Stevie-Nicks-and-the-Xaybanha-Zhous/SelectiveBirdFeeder/design_review/Design Review.docx

Team 9

Stevie Taylor

Nick Short

Calvin Xaybanha

Zeming Zhou

Design Review

Reviewers: Team 12

Miles Breslin

Miguel Higgins Moy

Noah Page

John Sharpe

- To-Do
  - Schematic:
    - Need to add linear regulator and make sure voltage nets are applied properly.
    - Add ISP header.
  - Board:
    - Need thicker traces all around.
    - Primarily surface mount components.
    - Need to add stitching vias.
