Stevie-Nicks-and-the-Xaybanha-Zhous/SelectiveBirdFeeder/system_design_models/Modeling.pdf

## ECE 411 Engineering Practices “System Design II:

## Behavior Models”

## Portland State University

## Nick Short

## Stevie Taylor

## Calvin Xaybanha

## Zeming Zhou

# State Machine View

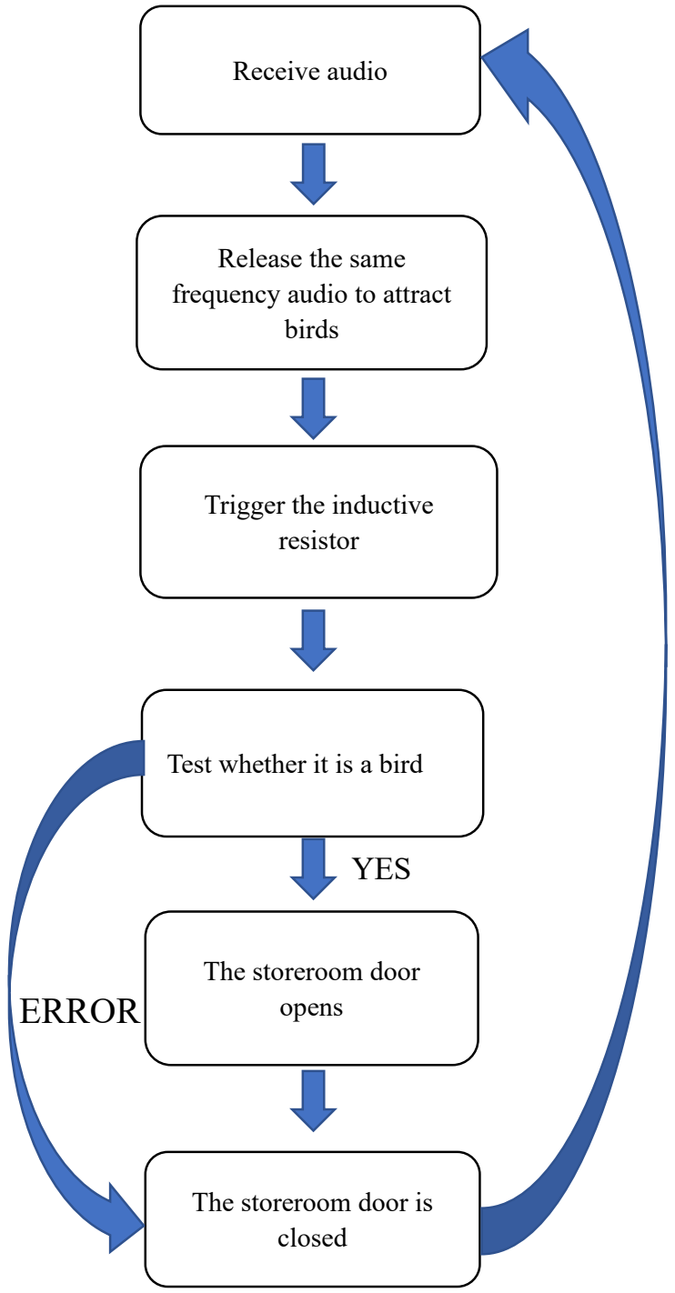
[picture p12: figure]
YES; ERROR; Receive audio; Release the same frequency audio to attract birds; Test whether it is a bird; The storeroom door opens; The storeroom door is closed; Trigger the inductive resistor

⚫ | Receives audio of the call of birds around the test device and tests the frequency range of
| the call.
⚫ | The audio, which is emitted at the same frequency as the receiving call, attracts birds to
| eat.
⚫ | Birds or other animals set out to sense the switch to test whether the animal belongs to the
| bird.
⚫ | If the test animal turns on the switch on the storage unit for birds.
⚫ | The bird leaves the sensor and receives a signal to turn off the switch on the storage device.

UML Activity View

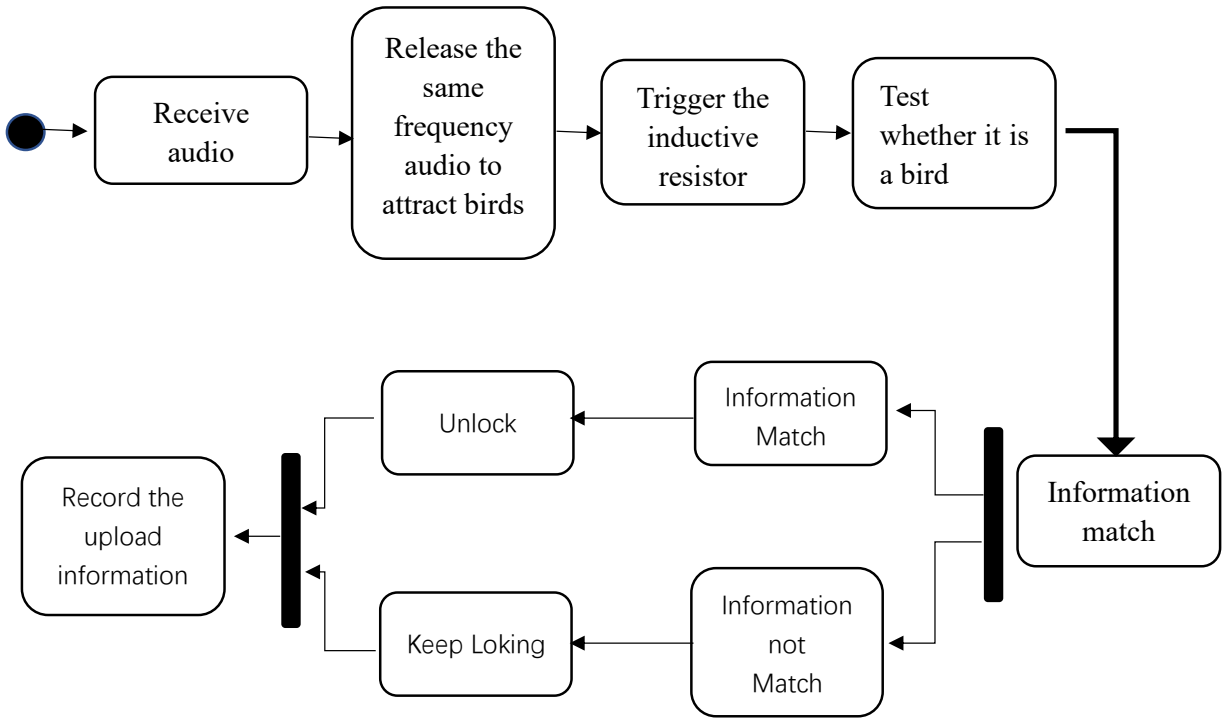
[picture p13: figure]
Receive audio; Release the same frequency audio to attract birds; Trigger the inductive resistor; Test whether it is a bird; Information match; Keep Loking; Information not Match; Unlock; Information Match; Record the upload information

The message that gets the bird's audio sends the same audio message to the bird to eat. When the sensor senses that an animal is in contact, it will determine whether the animal is a bird if the door circuit will be activated if it is not closed. Report bird information after the bird has finished eating.

Interaction View

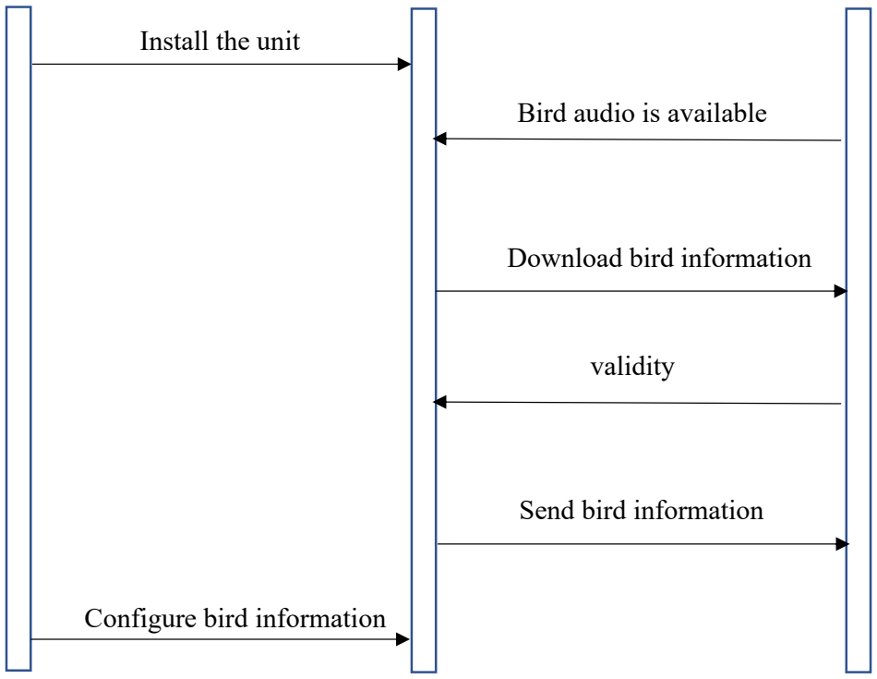
[picture p14: figure]
Install the unit; Bird audio is available; Download bird information; validity; Send bird information; Configure bird information

The user installs the sensor where it is to be tested. Sensors will collect bird information about the location to be measured, as well as bird call frequency information and bird species information. Upload and download bird information for future feeding of birds.

User | Processor | Smart Bird Feeder
