Stevie-Nicks-and-the-Xaybanha-Zhous/SelectiveBirdFeeder/test_plan_latex/design_documentation.tex

\begin{minipage}[c]{\textwidth}
	\centering	
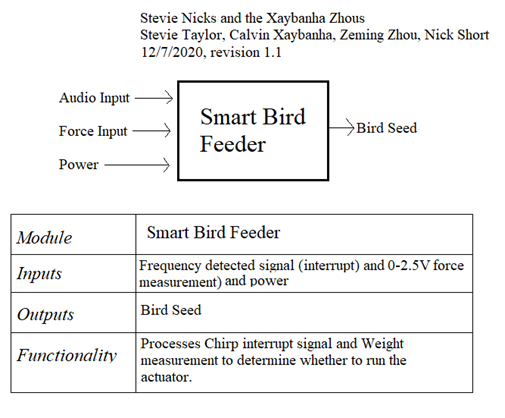
[picture p15: test_plan_latex/high_level.png]
	
\end{minipage}

\bigskip
