Stevie-Nicks-and-the-Xaybanha-Zhous/SelectiveBirdFeeder/level_view_design/detailed_design.pdf

## Level 0

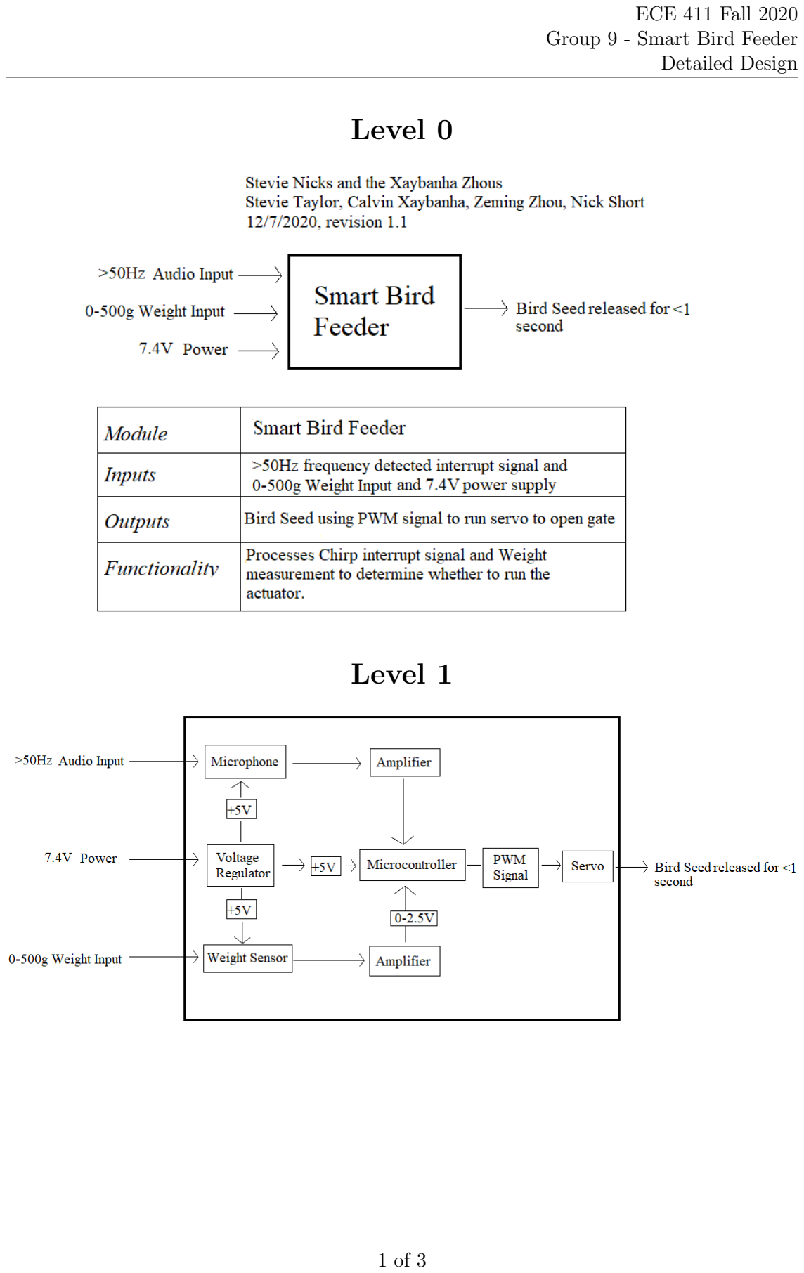
[picture p16: page 1]

ECE 411 Fall 2020
Group 9 - Smart Bird Feeder Detailed Design

## Level 1

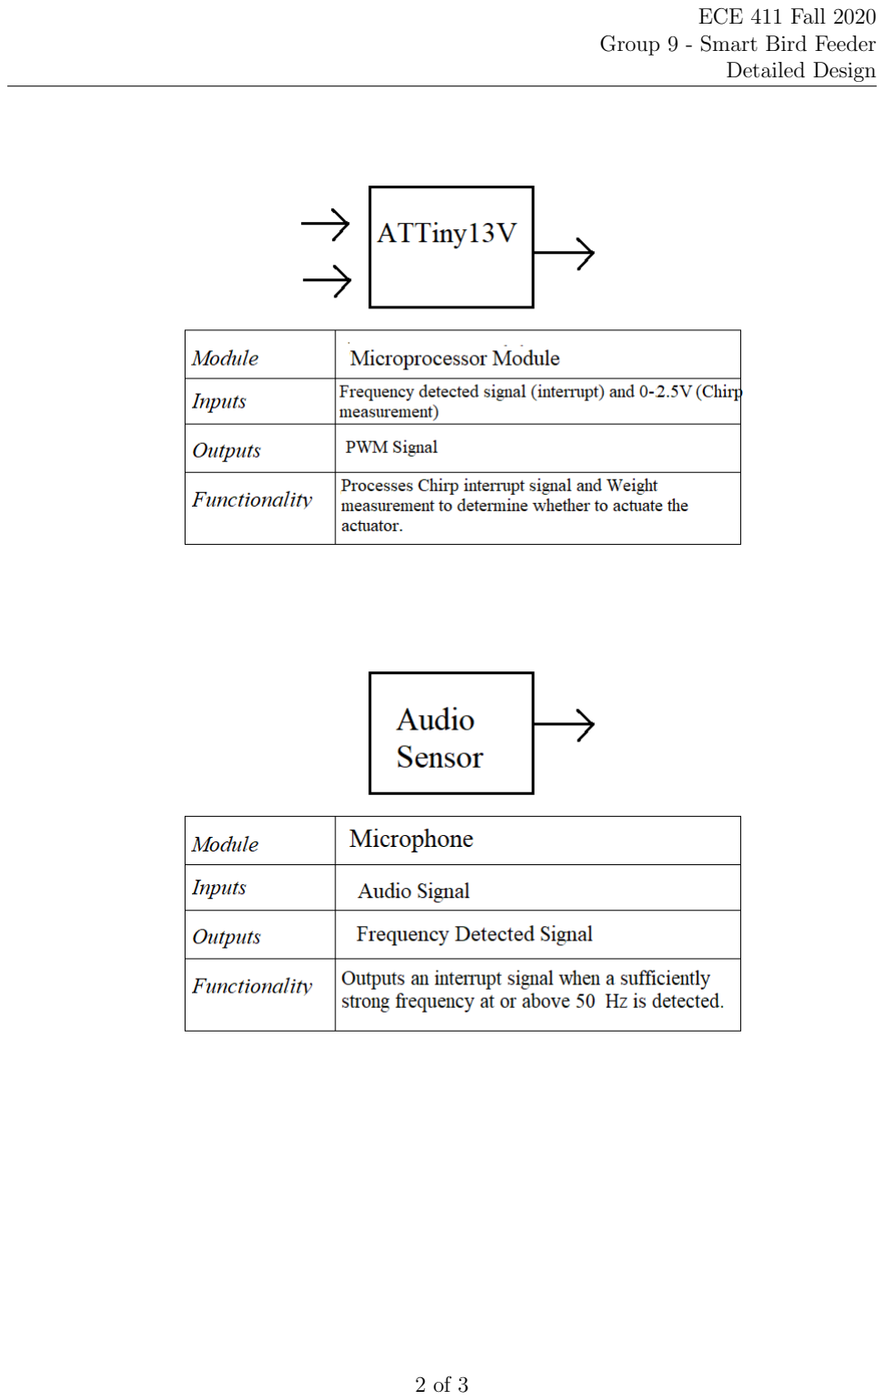
[picture p17: page 2]

Detailed Design

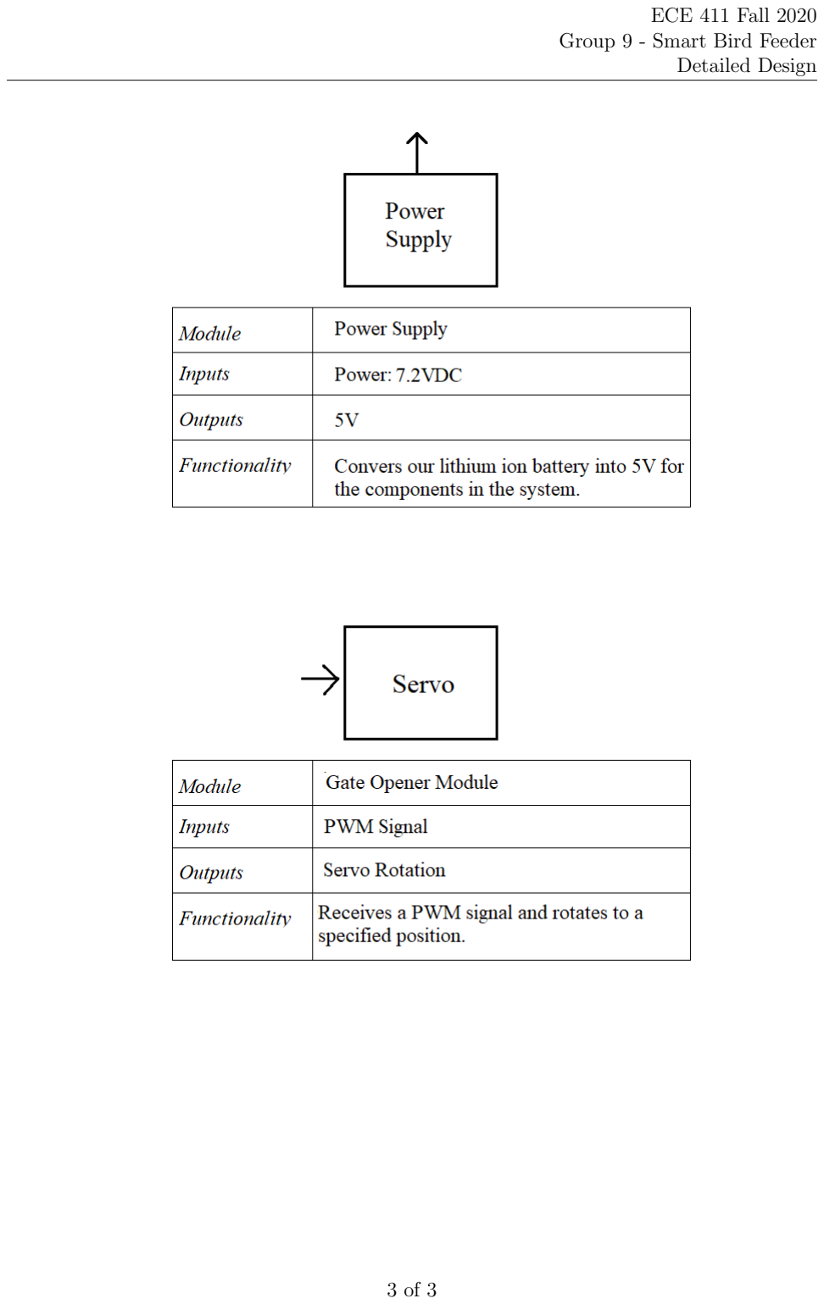
[picture p18: page 3]

Detailed Design
