Stevie-Nicks-and-the-Xaybanha-Zhous/SelectiveBirdFeeder/board_and_schematic/bird_feeder_board.PNG

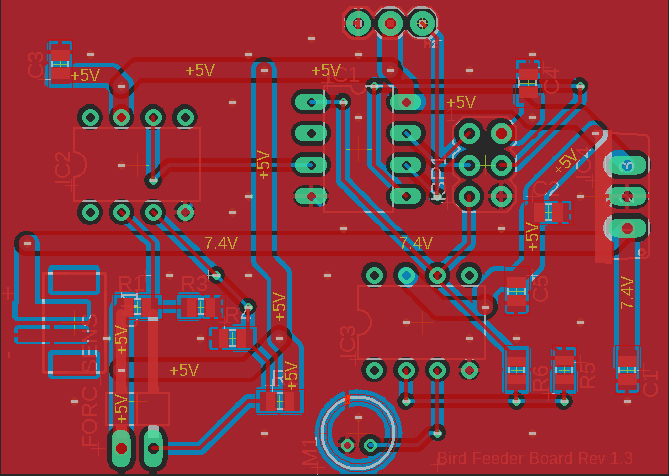
board_and_schematic/bird_feeder_board.PNG
