Stevie-Nicks-and-the-Xaybanha-Zhous/SelectiveBirdFeeder/bill_of_materials/team9_bird_feeder_bom.xlsx

Bill of Materials for Bird Feeder v1.1
Modified: 2020.12.08
source file: ece_411_team9_bird_feeder.brd
PCBA Part Number
PCBA revision 0
Index | Qty | Reference | Manufacturer | MPN | Description | Vendor | VPN | Unit Cost | Qty Cost
1 | 1 | IC1 | Atmel | ATTINY13V-10PU | 8-bit AVR Microcontroller with 1K Bytes In-System Programmable Flash | Mouser | 556-ATTINY13V10PQ | $1.30 | $1.30
2 | 2 | IC2, IC3 | Texas Instruments | LM741CN | OP-AMP | Mouser | 926-LM741CN/NOPB | $0.88 | $1.76
3 | 1 | M1 | HiLetgo | 3-01-0439 | Electret Condenser Microphone | Amazon | B00LZV1ERG | $4.49 | $4.49
4 | 1 | M2 | DFRobot | SER0043 | Servo Motor | Mouser | 426-SER0043 | $4.00 | $4.00
5 | 4 | R1, R2, R3, R4 | Yageo | RT0201FRE0710KL | Thin Film Resistor, 10K | Mouser | 603-RT0201FRE0710KL | $0.52 | $2.08
6 | 1 | R5 | Yageo | RT0805FRE101KL | Thin Film Resistor, 1K | Mouser | 603-RT0805FRE101KL | $0.12 | $0.12
7 | 1 | R6 | Yageo | AT0402DRE07100KL | Thin Film Resistor, 100K | Mouser | 603-AT0402DRE07100KL | $0.37 | $0.37
8 | 1 | C1 | KEMET | C0603C334K8RACAUTO | Multilayer Ceramic Capacitor SMT, 0.33uF | Mouser | 80-C0603C334K8RAUTO | $0.22 | $0.22
9 | 4 | C2, C3, C4, C5 | KEMET | C0402C104K8PAC7411 | Multilayer Ceramic Capacitor SMT, 0.1uF | Mouser | 80-C0402C104K8P7411 | $0.10 | $0.40
10 | 1 | SENSOR (Force Sensor) | Ohmite | FSR03CE | Force Sensing Resistor | Mouser | 588-FSR03CE | $11.36 | $11.36
11 | 1 | IC4 | Texas Instruments | LM7805CT/NOPB | Linear Voltage Regulator | Mouser | 926-LM7805CT/NOPB | $1.54 | $1.54
12 | 1 | CN1 | SparkFun | PRT-09749 | JST Right-Angle Connector TH 2-Pin | Mouser | 474-PRT-09749 | $0.95 | $0.95
13 | 1 | N/A | HHZ | N/A | 7.4V Lithium Battery | Amazon | B07Q2CFRKW | $14.99 | $14.99
 |  |  |  |  |  |  | Total Cost: |  | $43.58
