Stevie-Nicks-and-the-Xaybanha-Zhous/SelectiveBirdFeeder/(list of files, cad)

Other CAD files:
3D_CAD_Model/BirdFeeder_wChute_v2.f3d
3D_CAD_Model/Bird_Feeder_v3.f3d
