Stevie-Nicks-and-the-Xaybanha-Zhous/SelectiveBirdFeeder/test_plan_latex/computational_methods.tex

Force is in volts.

Frequency is in kilohertz.
