Stevie-Nicks-and-the-Xaybanha-Zhous/SelectiveBirdFeeder/test_plan_latex/group_9_smart_bird_feeder_test_plan.pdf

# ECE 411 Homework 7 - Test Plan

### Smart Bird Feeder Stevie Nicks and the Xaybanha Zhous - Group 9 Stevie Taylor, Zeming Zhou, Nick Short, Calvin Xaybanha

12/4/2020

### Version 1.0

1

CONTENTS | CONTENTS

## Contents

1 INTRODUCTION | 3
2 REFERENCE DOCUMENTS | 4
3 OVERVIEW | 5
4 PRETEST PREPARATION | 6
5 SYSTEM TESTS | 7

2

ECE 411 - 12/4/2020
Stevie Nicks and the Xaybanha Zhous Homework 7 - Test Plan

## 1 INTRODUCTION

### 1.1 This Document

Homework 7 - Test Plan

## 2 REFERENCE DOCUMENTS

### 2.1 Industry Standards

IEEE 1625-2004 - IEEE Standard for Rechargeable Batteries for Portable Computing (https://standards.ieee.org/standard/1625-2004.html)

### 2.2 Design Documentation


Homework 7 - Test Plan

## 3 OVERVIEW

### 3.1 Operational Description

The objective is to use a microcontroller to only release seed if the microphone is activated above a threshold frequency and the weight sensor feels a weight less than the threshold, above which is assumed to be a crow or squirrel.
The device will use a processing module to automatically dispense bird feed when a small bird is ”detected”. This is coded using a microcontroller to output a PWM which activates the servo to release seed based on the inputs sensed by the microphone activate with a chirp above the frequency threshold and a strain gauge sensor with a voltage related to the weight on the sensor below the weight threshold.

### 3.2 Definition of Terminology

Term: Weight sensor
Part Name: Force sensing resistor
Vendor: Mouser
Vendor Part Number: 588-FSR03CE
Definition: The sensor whose threshold will determine whether it is a small bird or large bird/squirrel.

Term: Microphone Part Name: Electret Condenser Microphone
Vendor: Amazon
Vendor Part Number: B00LZV1ERG
Definition: The sensor whose activation will determine if there is a bird trying to get seed.

Term: Gate opener
Part Name: Servo Motor
Vendor: Mouser
Vendor Part Number: 426-SER0043
Definition: The actuator which upon receiving the PWM signal from the microcontroller will rotate the servo to open the gate.

Term: Microcontroller
Part Name: 8-bit AVR Microcontroller with 1K bytes in-system programmable flash Vendor: Mouser
Vendor Part Number: 556-ATTINY13V10PQ
Definition: The process module that uses thresholds to determine whether a bird is chirping, its weight, which it then uses to send a PWM signal to activate the servo.

### 3.3 Computational Methods

Force is in volts.
Frequency is in kilohertz.

Homework 7 - Test Plan

## 4 PRETEST PREPARATION

### 4.1 Test Equipment

Oscilloscope
Digital Multimeter
Power Supply

### 4.2 Test Setup and Calibration

Apply the digital multimeter between the weight sensor and the microcontroller for the weight sensor test.
Apply the digital multimeter between the microcontroller and the gate opener.
Apply the oscilloscope probes between the microphone and the microcontroller.

Homework 7 - Test Plan

## 5 SYSTEM TESTS

### 5.1 Functional Tests

### 5.1.1 Power Switch and Indicator

### 5.1.2 Servo Test

## Test Case 1

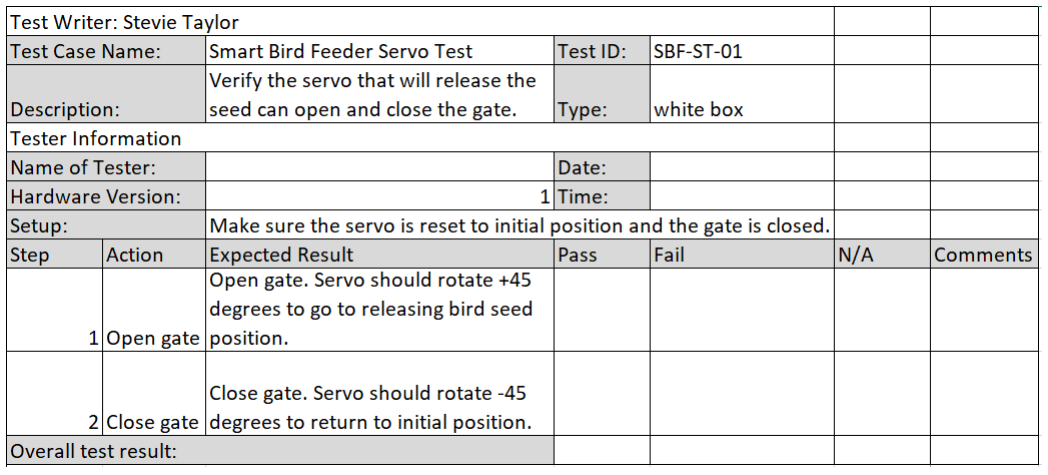
[picture p22: figure]

Homework 7 - Test Plan

### 5.1.3 Mass Sensor Test

## Test Case 2

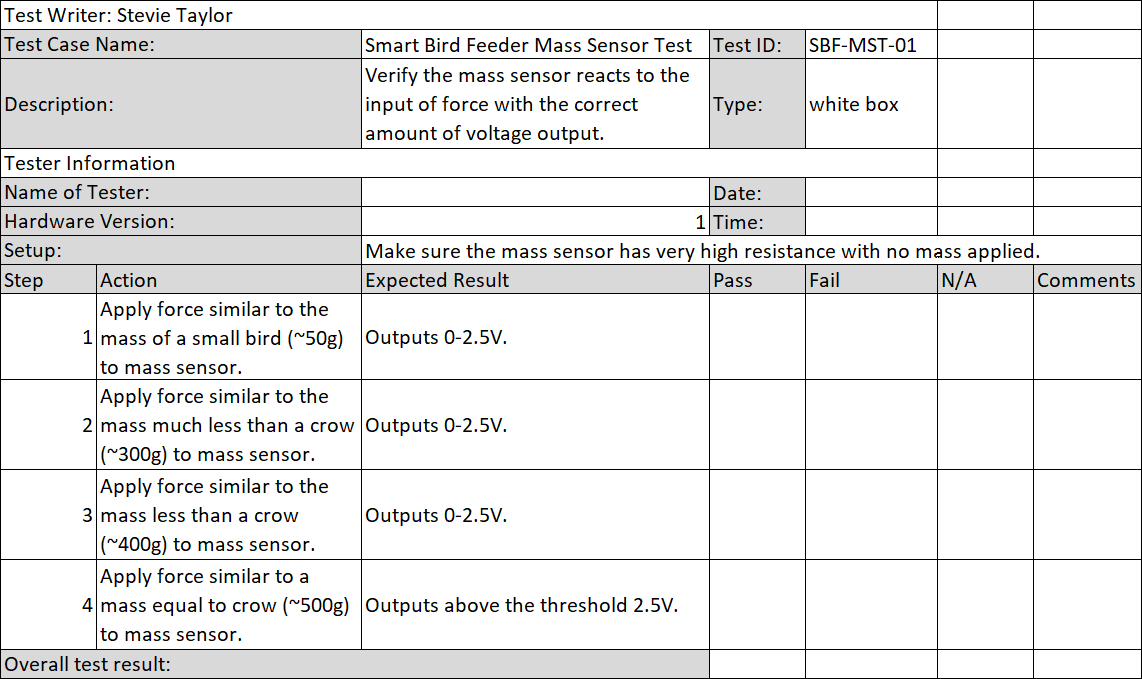
[picture p23: figure]

### 5.2 7 Day Stability

### 5.3 Vibration of Bird Landing on Device Stability Tests
