Stevie-Nicks-and-the-Xaybanha-Zhous/SelectiveBirdFeeder/tests/test_case_1_excel.xlsx

Test Writer: Stevie Taylor
Test Case Name: |  | Smart Bird Feeder Servo Test | Test ID: | SBF-ST-01
Description: |  | Verify the servo that will release the seed can open and close the gate. | Type: | white box
Tester Information
Name of Tester: |  |  | Date:
Hardware Version: |  | 1 | Time:
Setup: |  | Make sure the servo is reset to initial position and the gate is closed.
Step | Action | Expected Result | Pass | Fail | N/A | Comments
1 | Open gate | Open gate. Servo should rotate +45 degrees to go to releasing bird seed position.
2 | Close gate | Close gate. Servo should rotate -45 degrees to return to initial position.
Overall test result:
