Stevie-Nicks-and-the-Xaybanha-Zhous/SelectiveBirdFeeder/tests/test_case_2_excel.xlsx

Test Writer: Stevie Taylor
Test Case Name: |  | Smart Bird Feeder Mass Sensor Test | Test ID: | SBF-MST-01
Description: |  | Verify the mass sensor reacts to the input of force with the correct amount of voltage output. | Type: | white box
Tester Information
Name of Tester: |  |  | Date:
Hardware Version: |  | 1 | Time:
Setup: |  | Make sure the mass sensor has very high resistance with no mass applied.
Step | Action | Expected Result | Pass | Fail | N/A | Comments
1 | Apply force similar to the mass of a small bird (~50g) to mass sensor. | Outputs 0-2.5V.
2 | Apply force similar to the mass much less than a crow (~300g) to mass sensor. | Outputs 0-2.5V.
3 | Apply force similar to the mass less than a crow (~400g) to mass sensor. | Outputs 0-2.5V.
4 | Apply force similar to a mass equal to crow (~500g) to mass sensor. | Outputs above the threshold 2.5V.
Overall test result:
