Stevie-Nicks-and-the-Xaybanha-Zhous/SelectiveBirdFeeder/tests/TestCase1.JPG

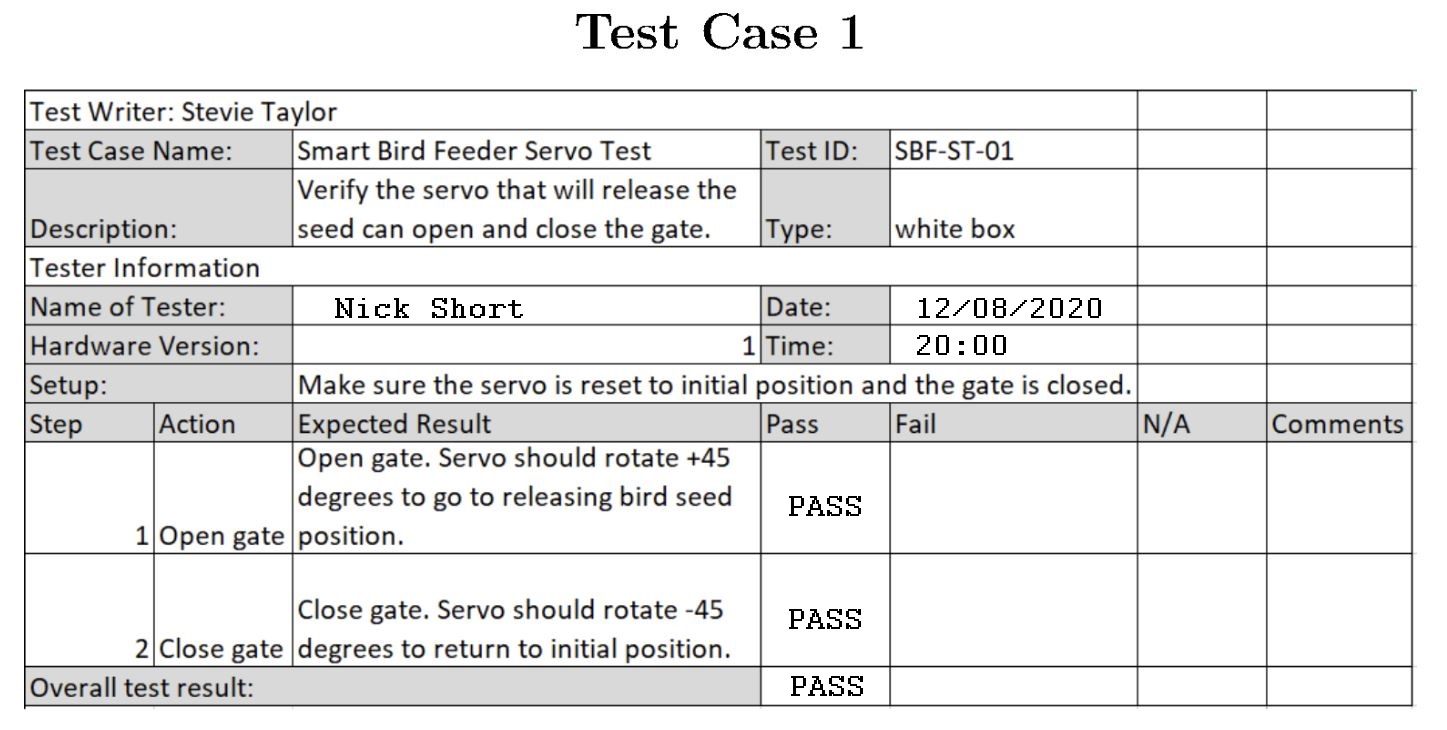
tests/TestCase1.JPG
