Stevie-Nicks-and-the-Xaybanha-Zhous/SelectiveBirdFeeder/tests/TestCase2.JPG

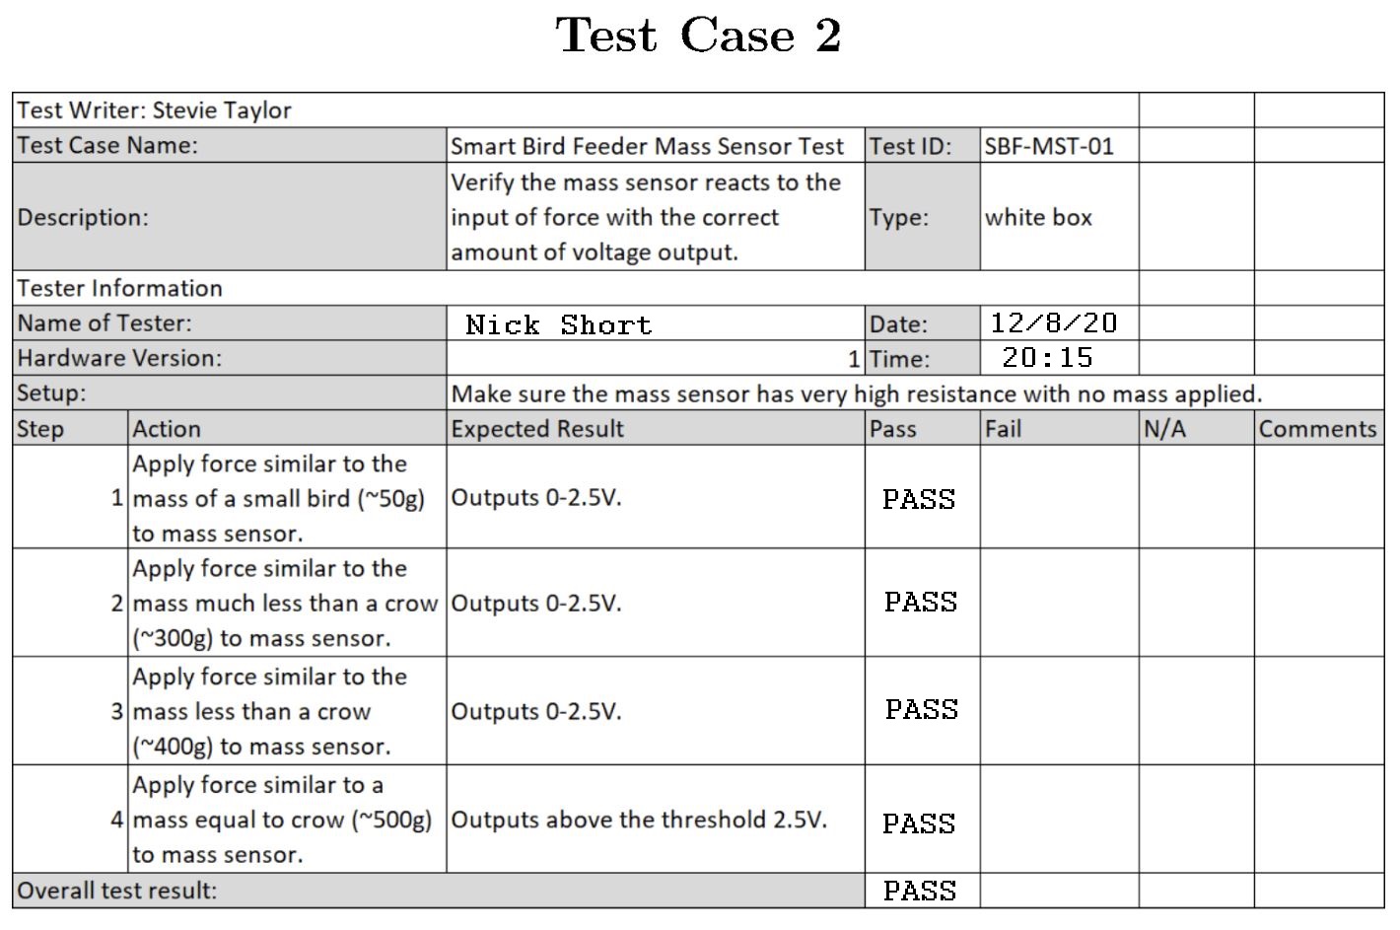
tests/TestCase2.JPG
