Stevie-Nicks-and-the-Xaybanha-Zhous/SelectiveBirdFeeder/board_and_schematic/bird_feeder_schematic.pdf

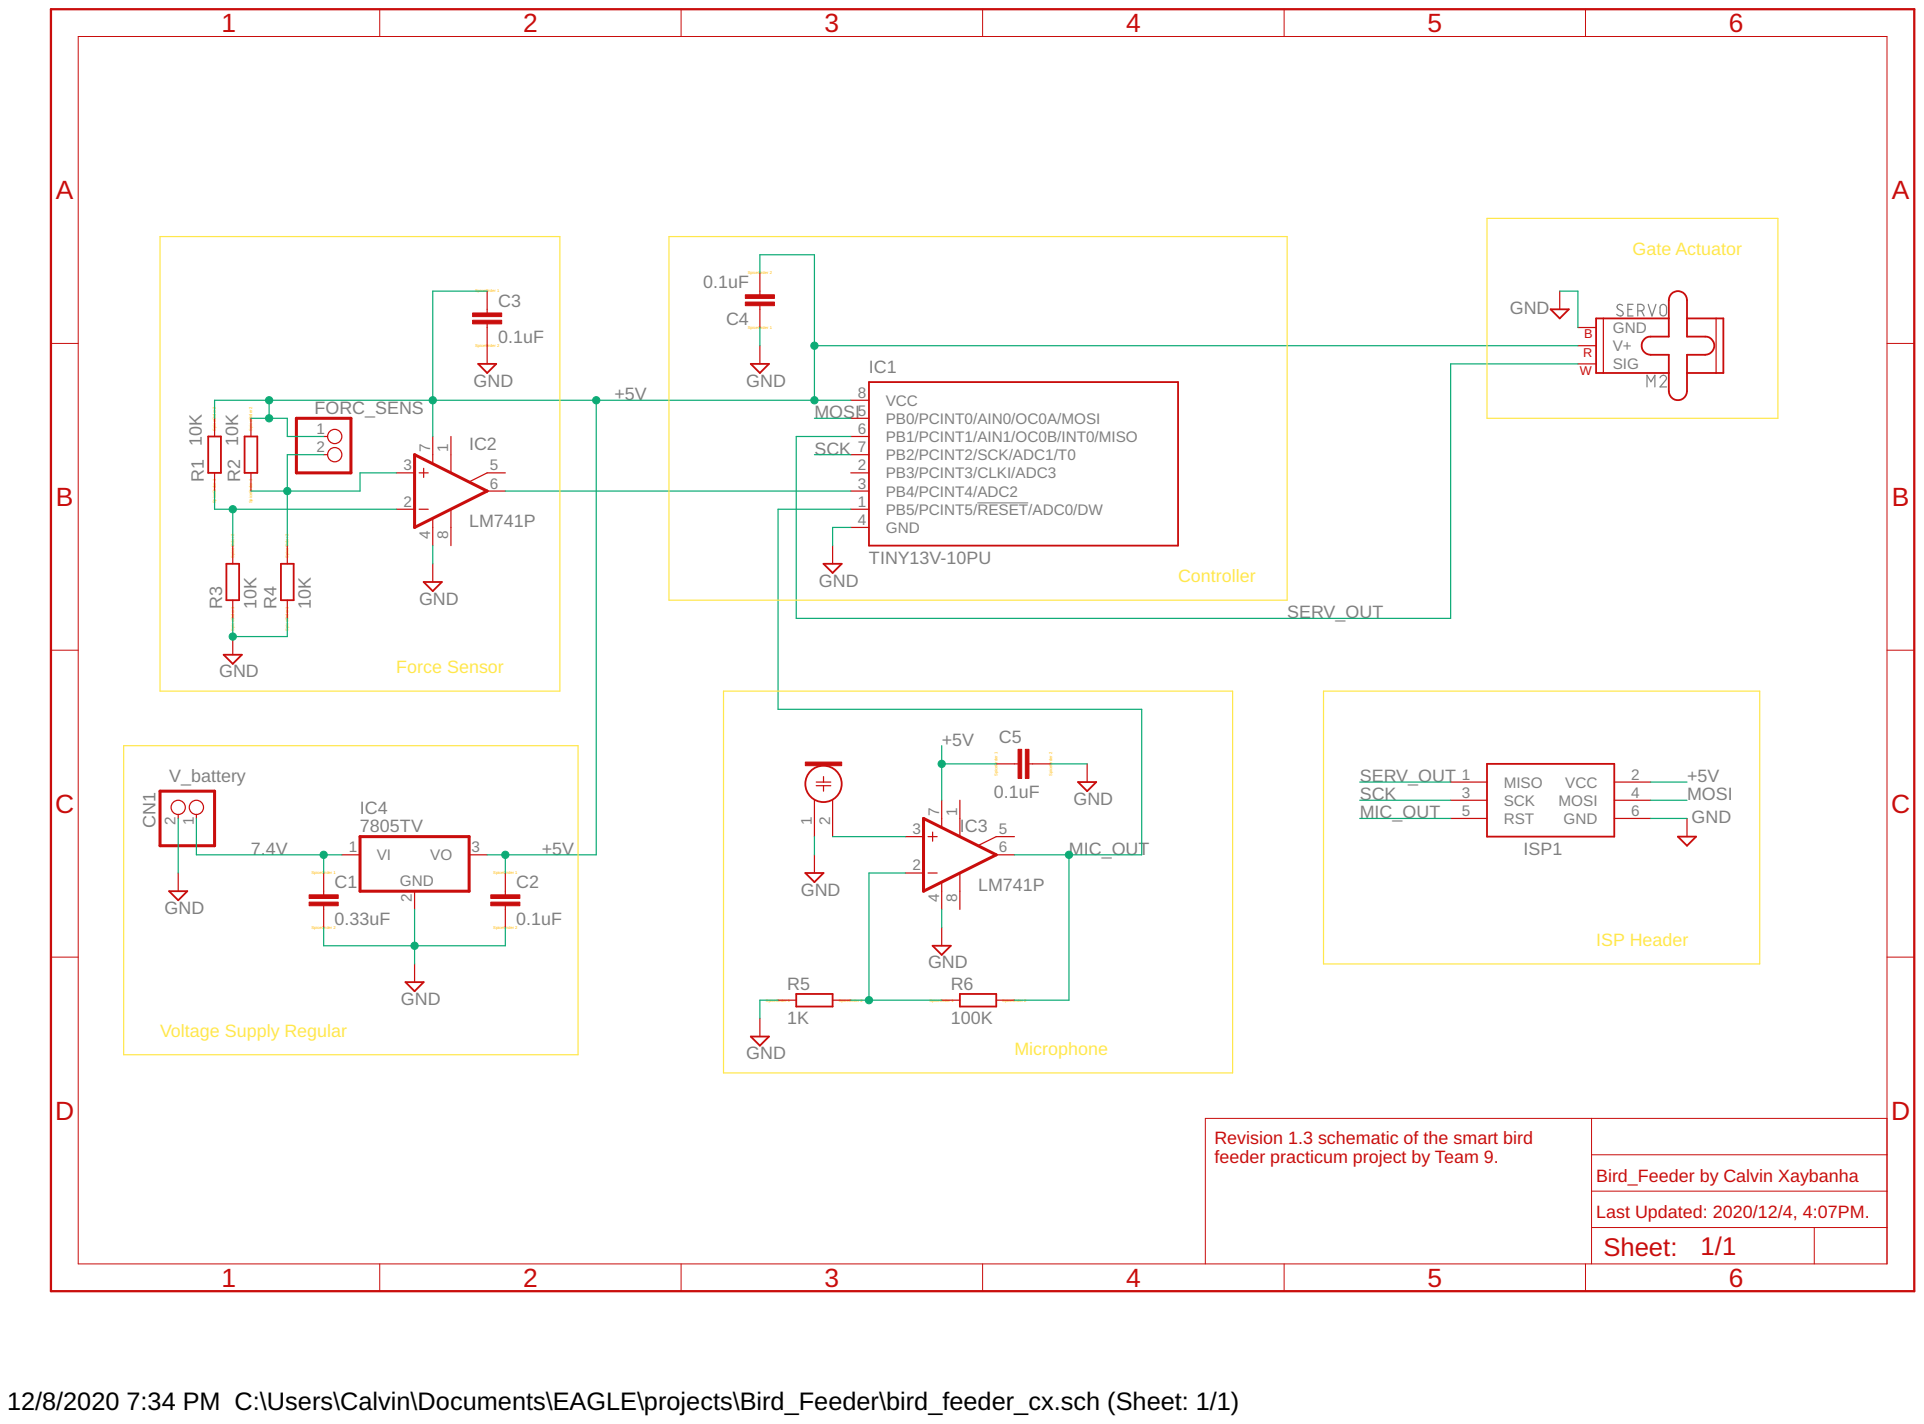
[picture p26: page 1]

SpiceOrder 1 SpiceOrder 2

feeder practicum project by Team 9. | Last Updated: 2020/12/4, 4:07PM. Revision 1.3 schematic of the smart bird

Sheet: 1/1

12/8/2020 7:34 PM C:\Users\Calvin\Documents\EAGLE\projects\Bird_Feeder\bird_feeder_cx.sch (Sheet: 1/1)
