Stevie-Nicks-and-the-Xaybanha-Zhous/SelectiveBirdFeeder/board_and_schematic/schematic.pdf

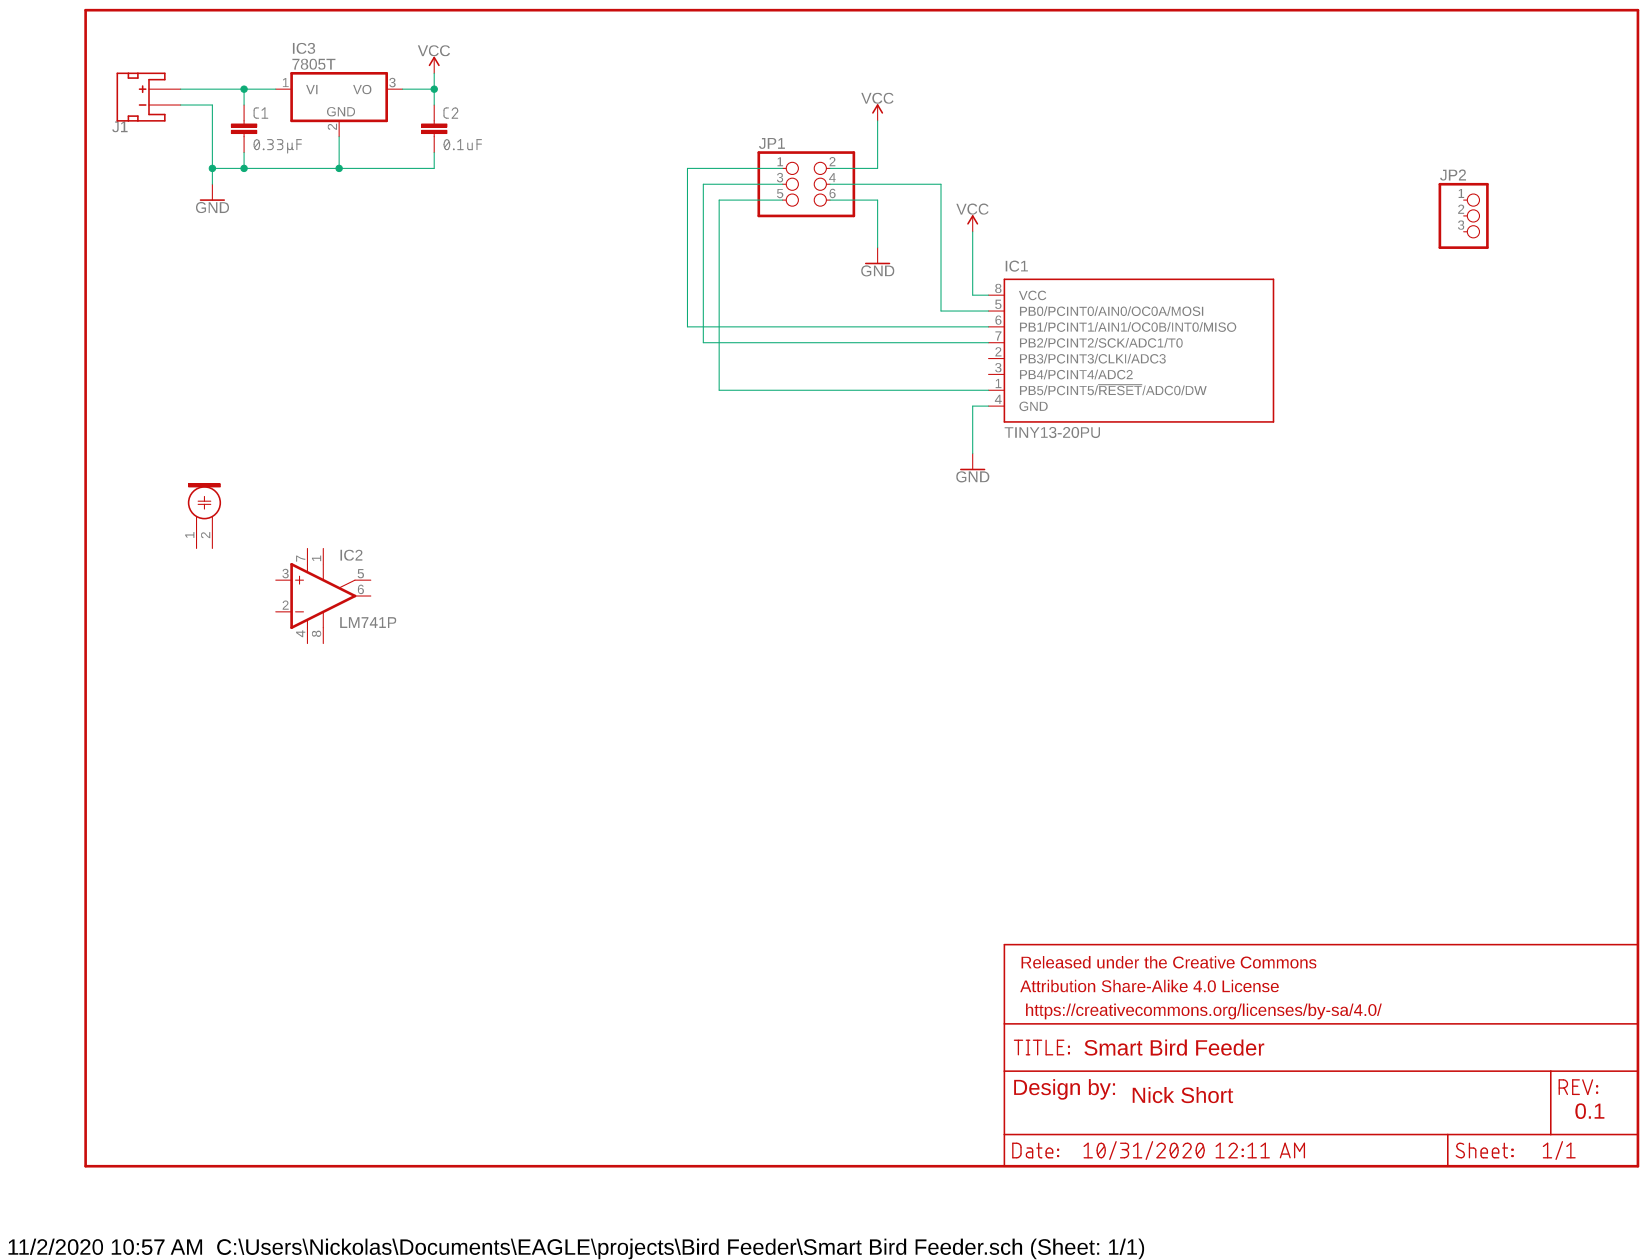
[picture p27: page 1]
