Stevie-Nicks-and-the-Xaybanha-Zhous/SelectiveBirdFeeder/board_and_schematic/ece_411_team9_bird_feeder.brd

## EAGLE design board_and_schematic/ece_411_team9_bird_feeder.brd (2020-12-05)

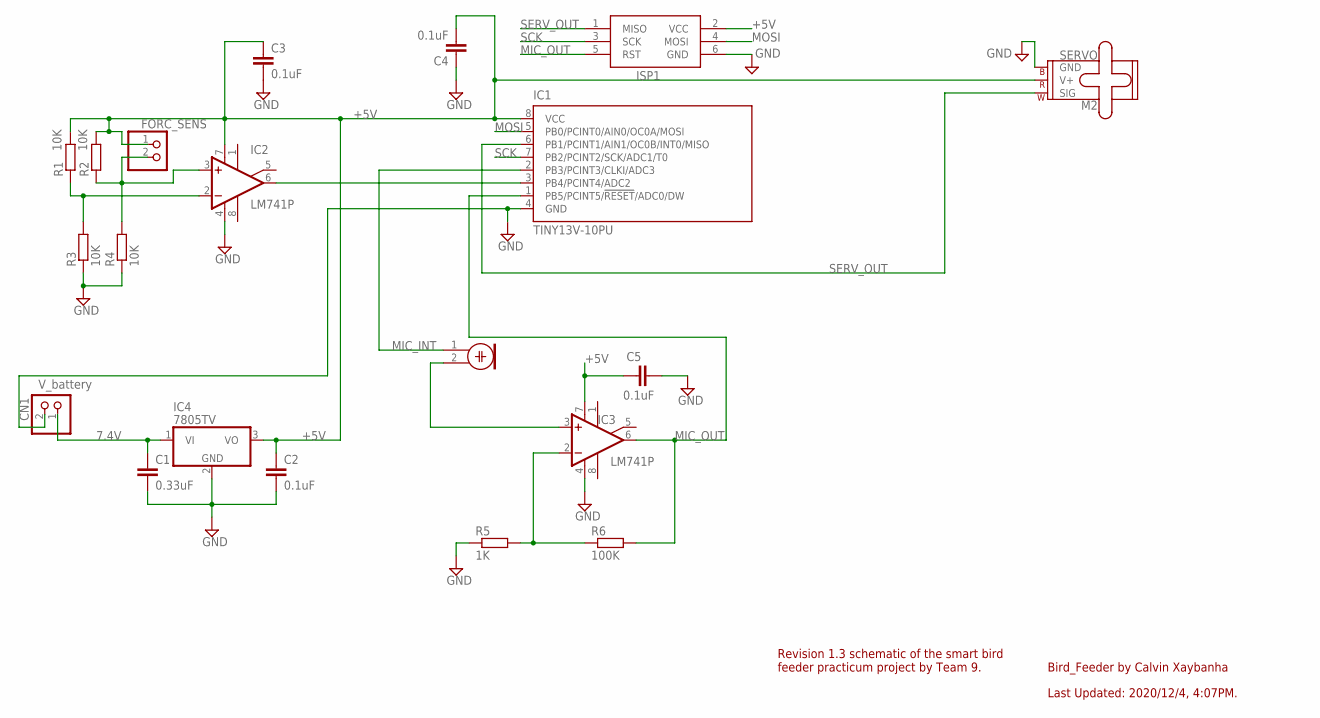
[picture p28: schematic ece_411_team9_bird_feeder.sch]

Parts:
C1: 0.33uF; C0805
C2, C3, C4, C5: 0.1uF; C0805
CN1: V_battery; JST-PH-2-SMT
FORC_SENS: PINHD-1X2/90; 1X02/90
IC1: TINY13V-10PU; DIL08
IC2, IC3: LM741P; DIL08
IC4: 7805TV; TO220V
ISP1: AVRISP-6; AVRISP
M1: ELECTRET_MICROPHON-WM.64PN; WM-64PN
M2: SERVO; 1X03
R1, R2, R3, R4: 10K; R0805
R5: 1K; R0805
R6: 100K; R0805

Connections:
7.4V: C1.1, CN1.1 (2), IC4.1 (VI)
+5V: C2.1, C3.1, C4.2, C5.1, FORC_SENS.1, IC1.8 (VCC), IC2.7 (V+), IC3.7 (V+), IC4.3 (VO), ISP1.2 (VCC), M2.2 (V+), R1.2, R2.2
FSNS_OP2: IC2.2 (-IN), R1.1, R3.2
FSNS_OP3: FORC_SENS.2, IC2.3 (+IN), R2.1, R4.2
FSNS_OUT: IC1.3 (PB4/PCINT4/ADC2), IC2.6 (OUT)
GND: C1.2, C2.2, C3.2, C4.1, C5.2, CN1.2 (1), IC1.4 (GND), IC2.4 (V-), IC3.4 (V-), IC4.2 (GND), ISP1.6 (GND), M2.3 (GND), R3.1, R4.1, R5.1
MIC_INT: IC1.2 (PB3/PCINT3/CLKI/ADC3), M1.1
MIC_OP2: IC3.2 (-IN), R5.2, R6.1
MIC_OP3: IC3.3 (+IN), M1.2
MIC_OUT: IC1.1 (PB5/PCINT5/!RESET!/ADC0/DW), IC3.6 (OUT), ISP1.5 (RST), R6.2
MOSI: IC1.5 (PB0/PCINT0/AIN0/OC0A/MOSI), ISP1.4 (MOSI)
SCK: IC1.7 (PB2/PCINT2/SCK/ADC1/T0), ISP1.3 (SCK)
SERV_OUT: IC1.6 (PB1/PCINT1/AIN1/OC0B/INT0/MISO), ISP1.1 (MISO), M2.1 (SIG)

Notes on the sheet:
Bird_Feeder by Calvin Xaybanha
Last Updated: 2020/12/4, 4:07PM.
Revision 1.3 schematic of the smart bird feeder practicum project by Team 9.

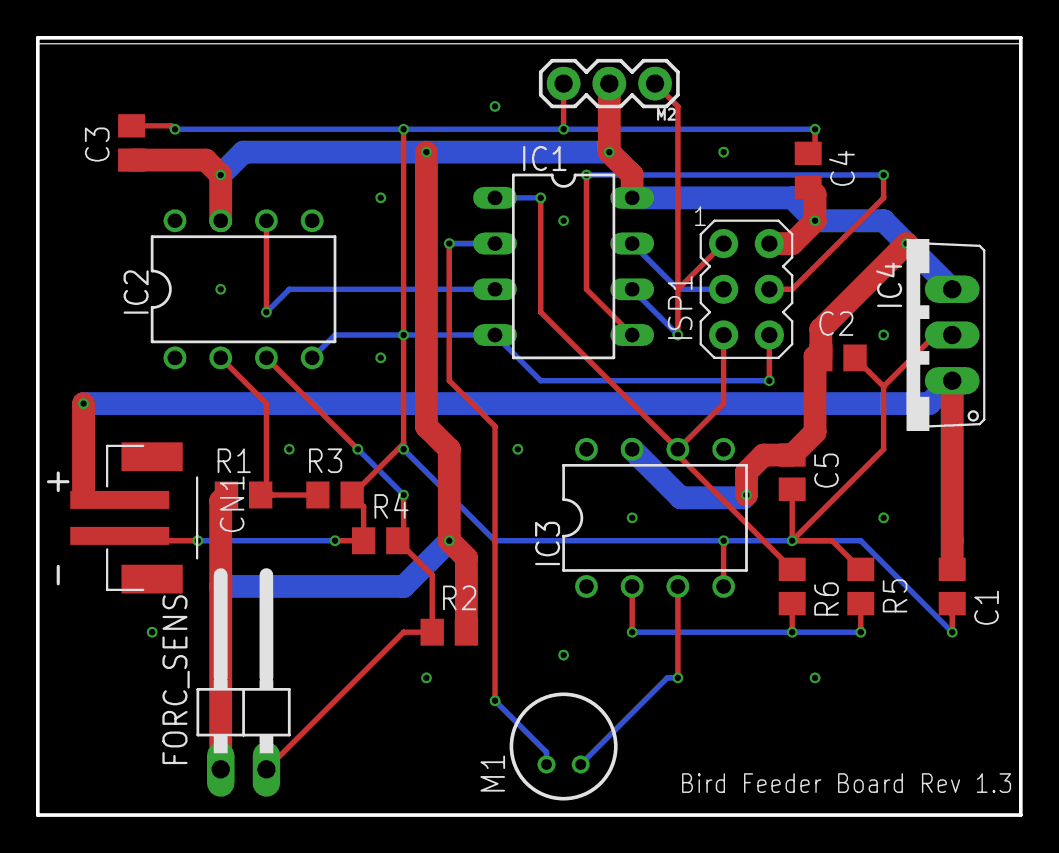
[picture p29: board ece_411_team9_bird_feeder.brd from above]

Board: 2 copper layers, 54.6 x 43.2 mm, 20 parts (0 on the bottom side), 13 nets.
