Stevie-Nicks-and-the-Xaybanha-Zhous/SelectiveBirdFeeder/(commit log)

2020-10-23 Add files via upload
    there's also a basin
    [BirdFeeder_wChute_v2.f3d]
2020-11-02 Add files via upload
    Picture of the first breadboard prototype. Very unfinished, just put them all together to show we have the parts and are working on the logic of what we're going to do.
2020-11-29 Add files via upload
    Ver. 1.1 Added stitching vias to ground.
    [ece_411_team9_bird_feeder.brd, ece_411_team9_bird_feeder.sch]
2020-11-30 Delete schematic.pdf
    Old schematic by Nick.
2020-11-30 Delete Smart Bird Feeder.sch
    Old Schematic by Nick.
    [Smart Bird Feeder.sch]
2020-12-08 Revert "Delete Smart Bird Feeder.sch"
    This reverts commit 9a062cfc9c5c2d0201783edef3fd41efebedd619.
    [Smart Bird Feeder.sch]
2020-12-08 Revert "Delete schematic.pdf"
    This reverts commit 6cc55b8744200834f0f4132ad1910ad3600d00bc.
2020-12-09 Add files via upload
    Added costs
    [team9_bird_feeder_bom.xlsx]
2020-12-09 Organized the schematic,board, and CAD models
    These were put into folders.
    [BirdFeeder_wChute_v2.f3d, Bird_Feeder_v3.f3d, Smart Bird Feeder.sch]
2020-12-09 Everything in Folders
    except the powerpoint
    [team9_bird_feeder_bom.xlsx]
2020-12-09 Add files via upload
    Reuploading just in case I changed anything last second.
