Stevie-Nicks-and-the-Xaybanha-Zhous/SelectiveBirdFeeder/board_and_schematic/breadboard.jpg

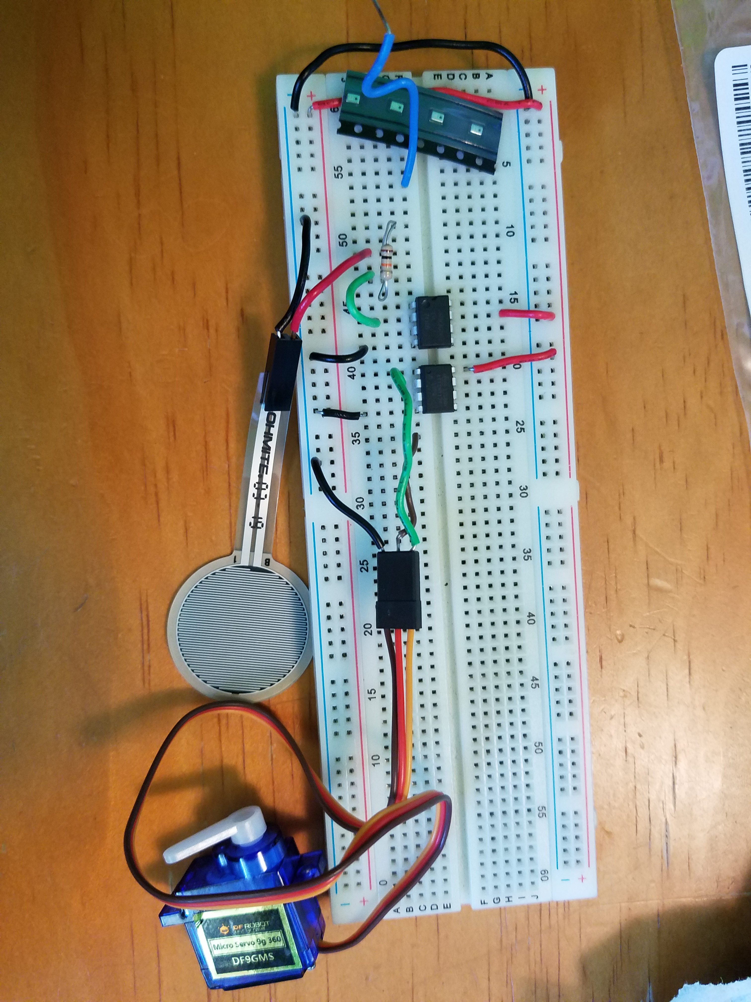
board_and_schematic/breadboard.jpg
